DKF-Engineering/evilfs/README.md

# evilfs
A lens adapter for Sony E mount integrating a TS style filter shifter with interchangeable filter drawers
