DKF-Engineering/evilfs/CAM Files/evilfs V11.stl

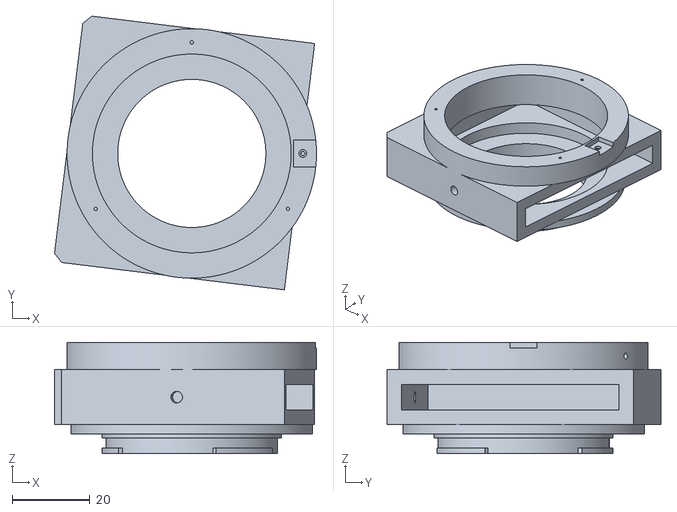
[picture p1: CAD file, 2017-04-11]
CAM Files/evilfs V11.stl
67.2 x 70.2 x 28.6
