DKF-Engineering/evilfs/(threads)

Thread 1 (2017-03-19):

E-Mount zu streng

DKF-Engineering, 2017-03-19:
Die drei Erhebungen des E-Mount sind zu hoch, der Adapter kann nicht aufgesteckt werden. Ca. 0,5mm bis 0,75mm erniedrigen.

DKF-Engineering, 2017-04-11:
Höhe auf von 2.0mm auf 1.5mm reduziert

Closed 2017-04-11.

Thread 6 (2017-03-19):

E-Mount ist verdreht

DKF-Engineering, 2017-03-19:
Erreicht nicht ganz die 90°, daher noch ca. 10°-20° weiter drehen.

DKF-Engineering, 2017-03-19:
TODO: Nochmal messen!

DKF-Engineering, 2017-04-11:
Käfig war um 7° verdreht, Bug behoben

Closed 2017-04-11.

Thread 7 (2017-03-19):

Aufnahme für Filterschublade zu breit

DKF-Engineering, 2017-03-19:
ca. 0.5mm schmäler machen! Ansonsten seitlicher Lichteinfall möglich!

DKF-Engineering, 2017-04-11:
Besser den Rücken der Filterschubladen etwas breiter gestalten, die Toleranz beim Einschieben ist aktuell sehr gut!

Closed 2017-04-11.
