DKF-Engineering/evilfs/(commit log)

2017-01-31 NEW: OpenSCAD draft of the very first version
    [evilfs.scad, evilfs.stl]
2017-01-31 NEW: external project by Thingiverse user gmcbay (http://www.thingiverse.com/thing:330812)
    [FujicaXtoEMount.scad]
2017-02-22 CHG: first valid version finished
    [FujicaXtoEMount.scad, evilfs.scad, evilfs.stl]
2017-04-11 BUG: Rotation des Filterkäfigs korrigiert BUG: E-Mount Markierung verschoben BUG: E-Mount war zu streng
    [FujicaXtoEMount.scad, evilfs.scad]
2017-04-11 CHG: neue Version 1.1
    [evilfs V10.stl, evilfs V11.stl]
2017-04-11 CHG: alte Version gelöscht
    [evilfs V10.stl]
